silllies/uranus-pcb-ruler/CAD/uranus-pcb-ruler.step

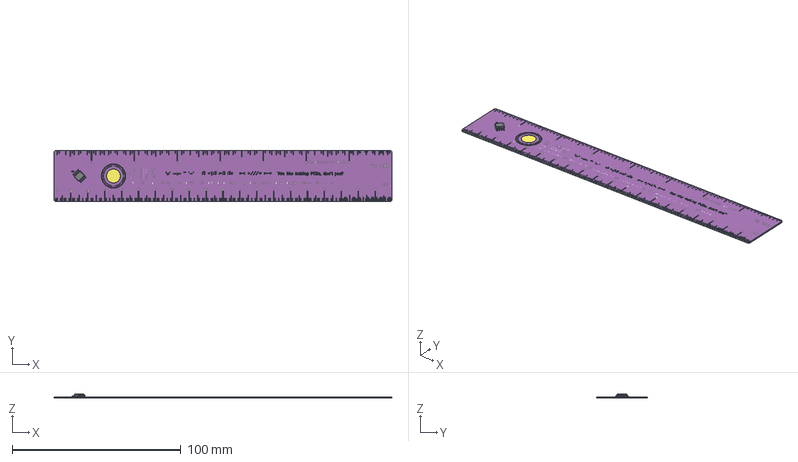
[picture p11: CAD file, 2026-11-01]
CAD/uranus-pcb-ruler.step
200.0 x 30.0 x 2.62 mm
SOIC-8_3.9x4.9mm_P1.27mm
C_0402_1005Metric
uranus-pcb-ruler-unsaved-export-Vg41bX_copper
uranus-pcb-ruler-unsaved-export-Vg41bX_silkscreen x 2
uranus-pcb-ruler-unsaved-export-Vg41bX_soldermask x 2
uranus-pcb-ruler-unsaved-export-Vg41bX_PCB
