silllies/uranus-pcb-ruler/PCB/uranus-pcb-ruler.kicad_pcb

## KiCad design PCB/uranus-pcb-ruler.kicad_pcb (2026-11-01)

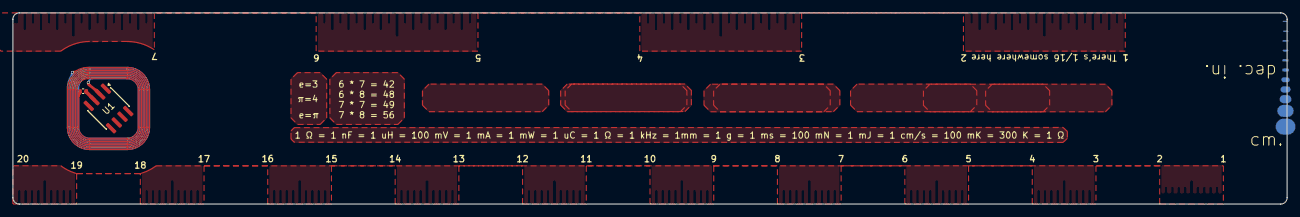
[picture p12: board uranus-pcb-ruler.kicad_pcb from above]

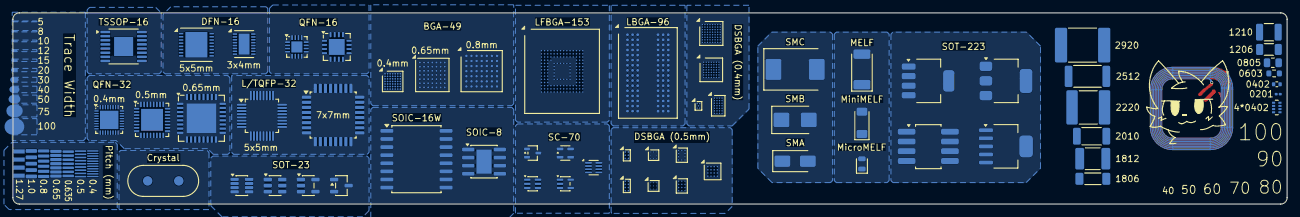
[picture p13: board uranus-pcb-ruler.kicad_pcb from below]

Board: 2 copper layers, 200.0 x 30.0 mm, 43 parts (41 on the bottom side), 2 nets.

Parts:
0.4mm: UCBGA-49_3x3mm_Layout7x7_P0.4mm
0.4mm#2: QFN-32-1EP_4x4mm_P0.4mm_EP2.9x2.9mm
0.8mm: Analog_BGA-49_6.25x6.25mm_Layout7x7_P0.8mm
0.65mm: QFN-32-1EP_7x7mm_P0.65mm_EP4.65x4.65mm
3x4mm: DFN-16-1EP_3x4mm_P0.45mm_EP1.7x3.3mm
4*0402: R_Array_Concave_4x0402
7x7mm: LQFP-32_7x7mm_P0.8mm
0201: R_0201_0603Metric
0402: R_0402_1005Metric
0603: R_0603_1608Metric
0805: R_0805_2012Metric
1206: R_1206_3216Metric
1210: R_1210_3225Metric
1806: L_1806_4516Metric
1812: C_1812_4532Metric
2010: R_2010_5025Metric
2220: C_2220_5750Metric
2512: R_2512_6332Metric
2920: Fuse_2920_7451Metric
BGA-49: VFBGA-49_5.0x5.0mm_Layout7x7_P0.65mm
C2: 0F; C_0402_1005Metric
Crystal: Crystal_HC49-U_Vertical
DFN-16: DFN-16-1EP_5x5mm_P0.5mm_EP3.46x4mm
DSBGA (0.4mm): Texas_DSBGA-64_3.415x3.535mm_Layout8x8_P0.4mm
DSBGA (0.5mm): Texas_DSBGA-8_0.9x1.9mm_Layout2x4_P0.5mm
L/TQFP-32: LQFP-32_5x5mm_P0.5mm
LBGA-96: Micron_FBGA-96_9x14mm_Layout9x16_P0.8mm
LFBGA-153: LFBGA-153_11.5x13mm_Layout14x14_P0.5mm
MELF: D_MELF
MicroMELF: D_MicroMELF
MiniMELF: D_MiniMELF
QFN-16: QFN-16-1EP_3x3mm_P0.5mm_EP1.75x1.75mm
QFN-32: QFN-32-1EP_5x5mm_P0.5mm_EP3.45x3.45mm
SC-70: SOT-323_SC-70
SMA: D_SMA
SMB: D_SMB
SMC: D_SMC
SOIC-8: SOIC-8-1EP_3.9x4.9mm_P1.27mm_EP2.41x3.81mm
SOIC-16W: SOIC-16W_7.5x10.3mm_P1.27mm
SOT-23: SOT-23-6
SOT-223: SOT-223
TSSOP-16: TSSOP-16-1EP_4.4x5mm_P0.65mm_EP3x3mm
U1: ST25DV04KC-IE8S3; SOIC-8_3.9x4.9mm_P1.27mm

Connections:
unnamed: C2.1, U1.2 (AC0)
unnamed: C2.2, U1.3 (AC1)
