silllies/uranus-pcb-ruler/(commit log)

2026-10-27 First day
    * First day
    * First day
    * plz help
    * fixed LaTeX typo
    [BOM.csv, uranus-pocket-tbc.kicad_pcb, uranus-pocket-tbc.kicad_sch]
2026-10-27 update schematic, oops
    [uranus-pocket-tbc.kicad_pcb, uranus-pocket-tbc.kicad_sch]
2026-10-27 rename KiCad files
    [uranus-pcb-ruler.kicad_pcb, uranus-pcb-ruler.kicad_sch]
2026-11-01 yaaaaaayyyyyyy
    * Catch up. kinda forgot to push earlier days
    * forgot to save kicad
    * obsidian is too smart
    * Delete CAD/.gitkeep
    * removed kicad lib tables
    [BOM.csv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]
